kaibeckmann/weather-balloon-hat/images/PCB_board-top.png

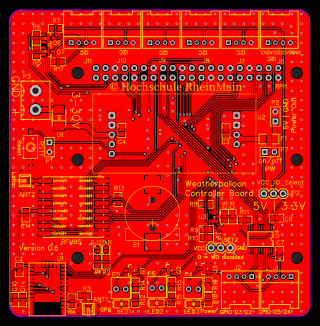
images/PCB_board-top.png
