kaibeckmann/weather-balloon-hat/images/schematic-sheet1.png

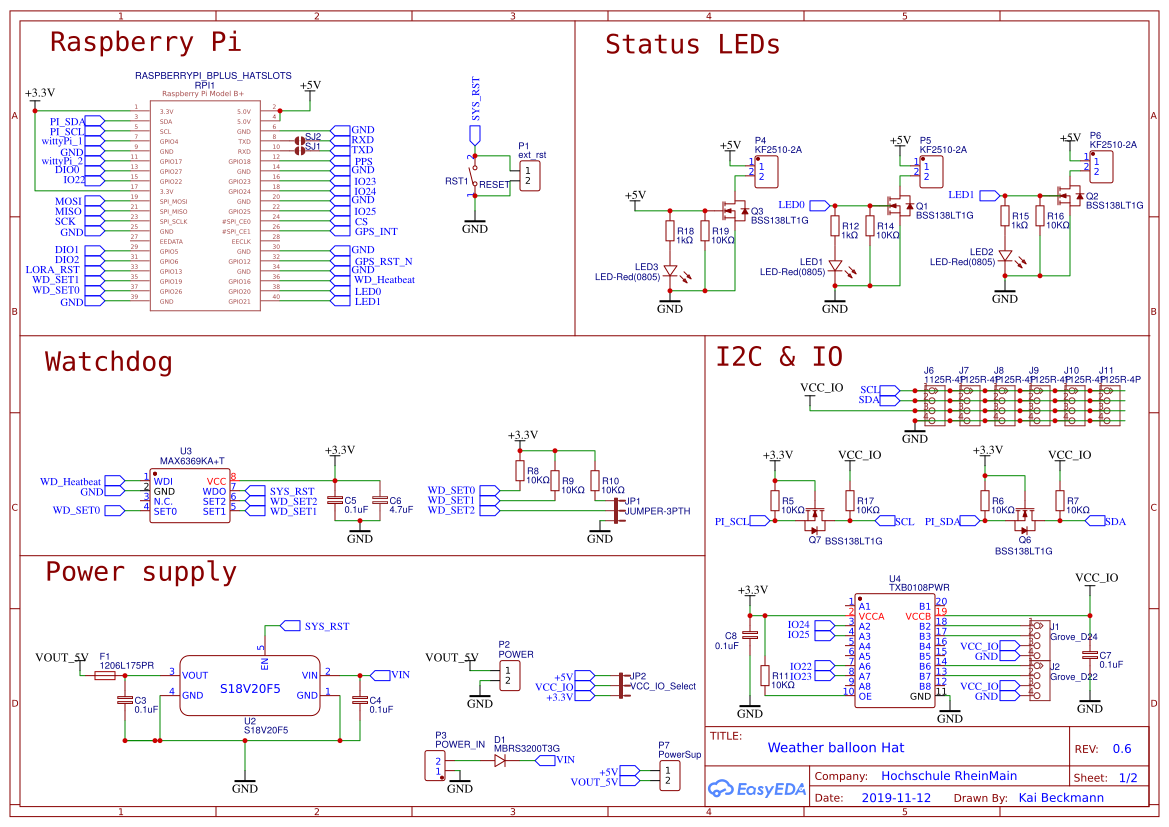
images/schematic-sheet1.png
