kaibeckmann/weather-balloon-hat/images/schematic-sheet2.png

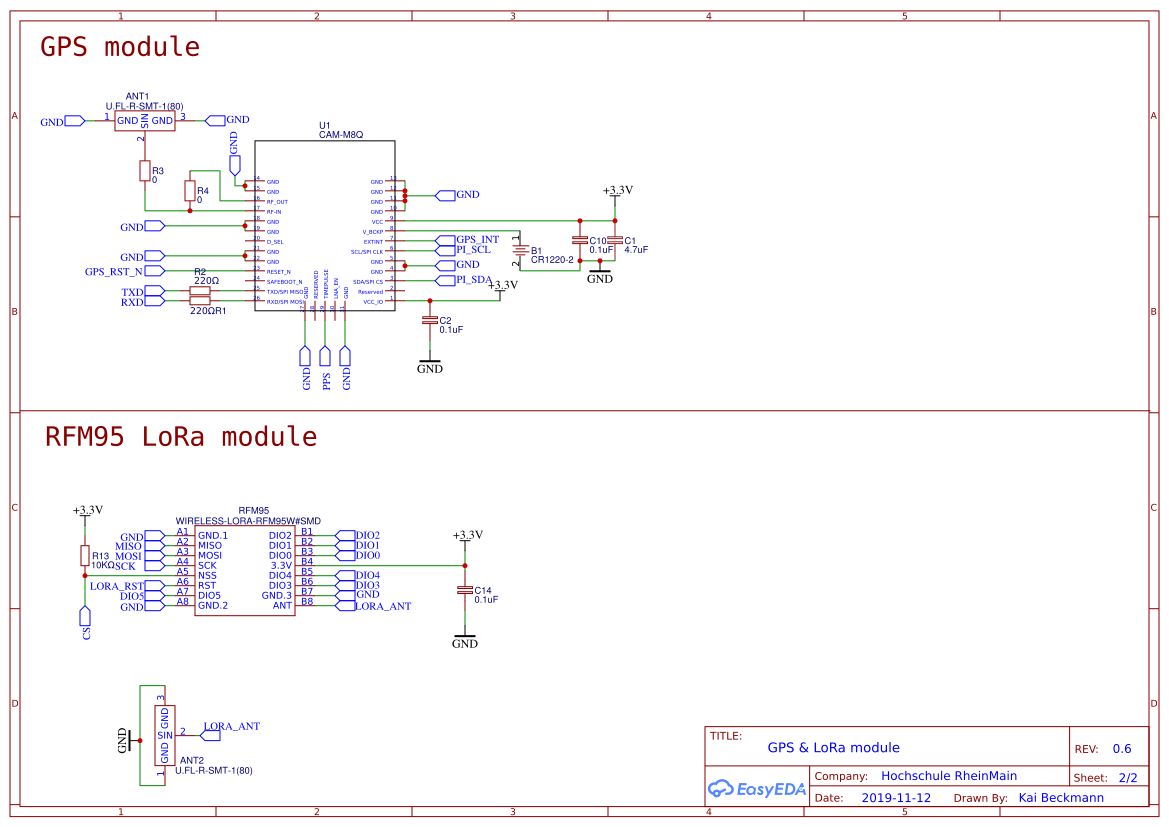
images/schematic-sheet2.png
