kaibeckmann/weather-balloon-hat/BOM/BOM_Weatherballoon-Hat_v0.6.csv

ID | Name | Designator | Footprint | Quantity | Manufacturer Part | Manufacturer | Supplier | Supplier Part | Value | LCSC Assembly | Tolerance | Voltage
1 | 10KΩ | R8,R9,R10,R11,R14,R16,R19,R7,R6,R5,R17 | 0805' | 11 | 0805W8F1002T5E | Uniroyal Elec | LCSC | C17414 | 10KΩ
2 | 1kΩ | R12,R15,R18 | 0805' | 3 | 0805W8F1001T5E | Uniroyal Elec | LCSC | C17513
3 | U.FL-R-SMT-1(80) | ANT1,ANT2 | U.FL-R-SMT-1(80) | 2 | U.FL-R-SMT-1(80) | HRS | LCSC | C88374
4 | 220Ω | R2,R1 | 0805' | 2
5 | 10KΩ | R13 | 0805' | 1 | 0805W8F1002T5E | UniOhm | LCSC | C17414 | 10KΩ
6 | WIRELESS-LORA-RFM95W#SMD | RFM95 | WIRELESS-LORA-RFM95WSMD | 1 | RFM95W-868S2 |  | RS-Online | 125-1259
7 | ext_rst | P1 | HDR-1X2/2.54 | 1 | 2.54-1*2PFemale | BOOMELE | LCSC | C49661
8 | POWER | P2 | HDR-1X2/2.54 | 1 | 2.54-1*2PFemale | BOOMELE | LCSC | C49661
9 | PowerSup | P7 | HDR-1X2/2.54 | 1 | 2.54-1*2PFemale | BOOMELE | LCSC | C49661
10 | TXB0108PWR | U4 | TSSOP-20 | 1 | TXB0108PWR | TI | LCSC | C53406 |  | Yes
11 | SOLDERJUMPERNO | SJ1,SJ2 | SJ_2S-NO | 2
12 | 0.1uF | C3,C4,C5,C7,C8,C2,C10,C14 | 0805' | 8 | CL21B105KAFNNNE | Samsung | LCSC | C116352 | 0.1uF |  | ±10% | 25V
13 | 4.7uF | C6,C1 | 0805' | 2
14 | Grove_D24 | J1 | HW4-2.0-90D | 1 | 1125R-4P
15 | Grove_D22 | J2 | HW4-2.0-90D | 1 | 1125R-4P
16 | 1125R-4P | J6,J7,J8,J9,J10,J11 | HW4-2.0-90D | 6 | 1125R-4P
17 | RASPBERRYPI_BPLUS_HATSLOTS | RPI1 | PI_HAT_SLOTS_COMBI | 1
18 | MAX6369KA+T | U3 | SOT-23-8 | 1 | MAX6369KA+T | MAXIM | LCSC | C128613 |  | Yes
19 | KF2510-2A | P4,P5,P6 | KF2510-2A | 3 | KF2510-2A | BOOMELE | LCSC | C27543
20 | 0 | R4,R3 | 0805' | 2
21 | CR1220-2 | B1 | BATTERY-2 | 1 | CR1220-2 | Q&J | LCSC | C70381
22 | JUMPER-3PTH | JP1 | 1X03 | 1
23 | VCC_IO_Select | JP2 | 1X03 | 1
24 | 1206L175PR | F1 | 1206 | 1 | 1206L175PR | Littelfuse | LCSC | C207038
25 | LED-Red(0805) | LED1,LED2,LED3 | LED-0805 | 3 | 17-21SURC/S530-A2/TR8 | Everlight Elec | LCSC | C131244
26 | CAM-M8Q | U1 | CAM-M8Q | 1 | CAM-M8Q | U-BLOX | Digi-Key | 672-1013-1-ND
27 | POWER_IN | P3 | WJ2EDGVC-5.08-2P | 1 | WJ2EDGVC-5.08-2P | ReliaPro | LCSC | C8445
28 | RESET | RST1 | K2-1107ST-A4SW-06 | 1 | K2-1107ST-A4SW-06 | Rectangular Connectors - Contacts | LCSC | C118141
29 | BSS138LT1G | Q1,Q2,Q3,Q6,Q7 | SOT-23(SOT-23-3) | 5 | BSS138LT1G | ON | LCSC | C82045 |  | Yes
30 | S18V20F5 | U2 | S18V20F5 | 1
31 | MBRS3200T3G | D1 | SMB(DO-214AA) | 1 | MBRS3200T3G | ON | LCSC | C86674 |  | Yes
