kaibeckmann/weather-balloon-hat/BOM/PCB_board-assembly.pdf

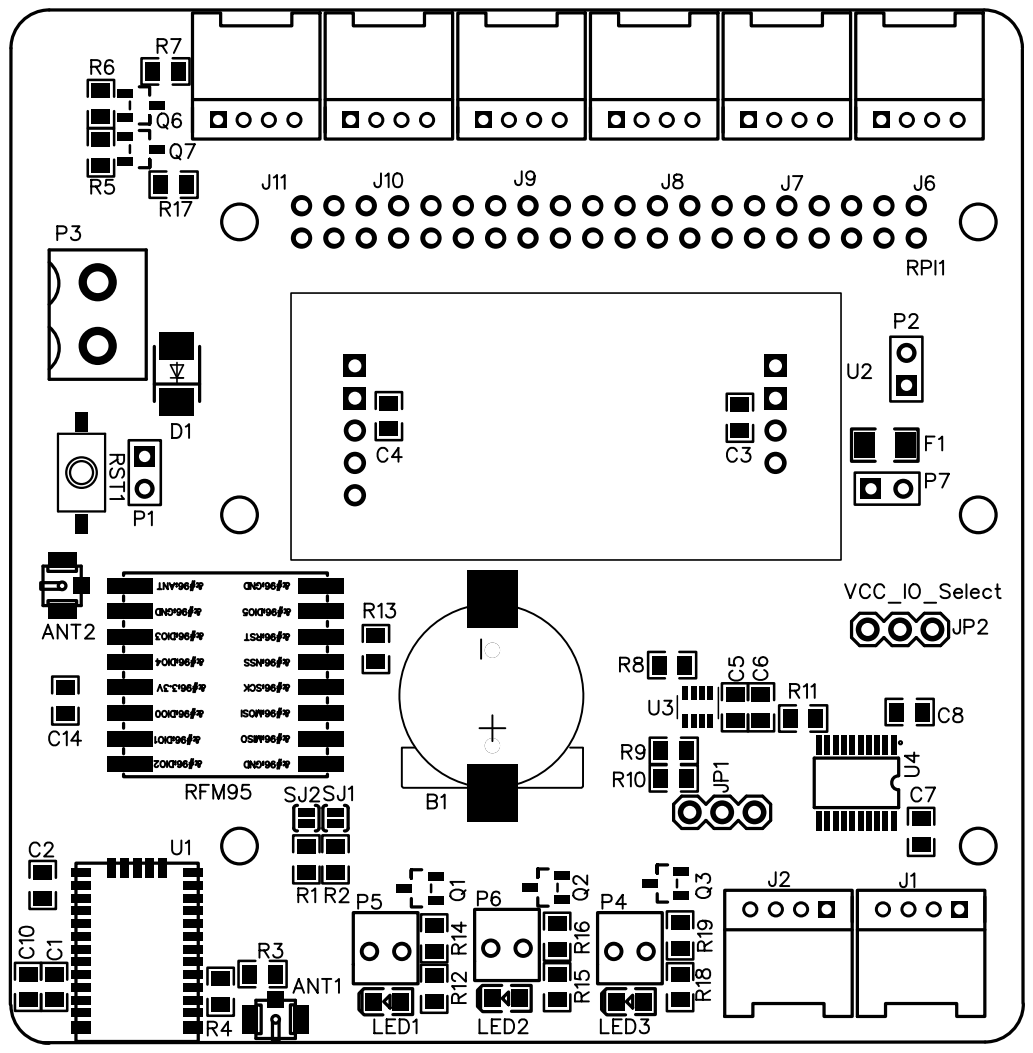
[picture p6: page 1]
