kaibeckmann/weather-balloon-hat/schematic/Schematic_Weatherballoon-Hat_v0.6.pdf

+5V
+3.3V

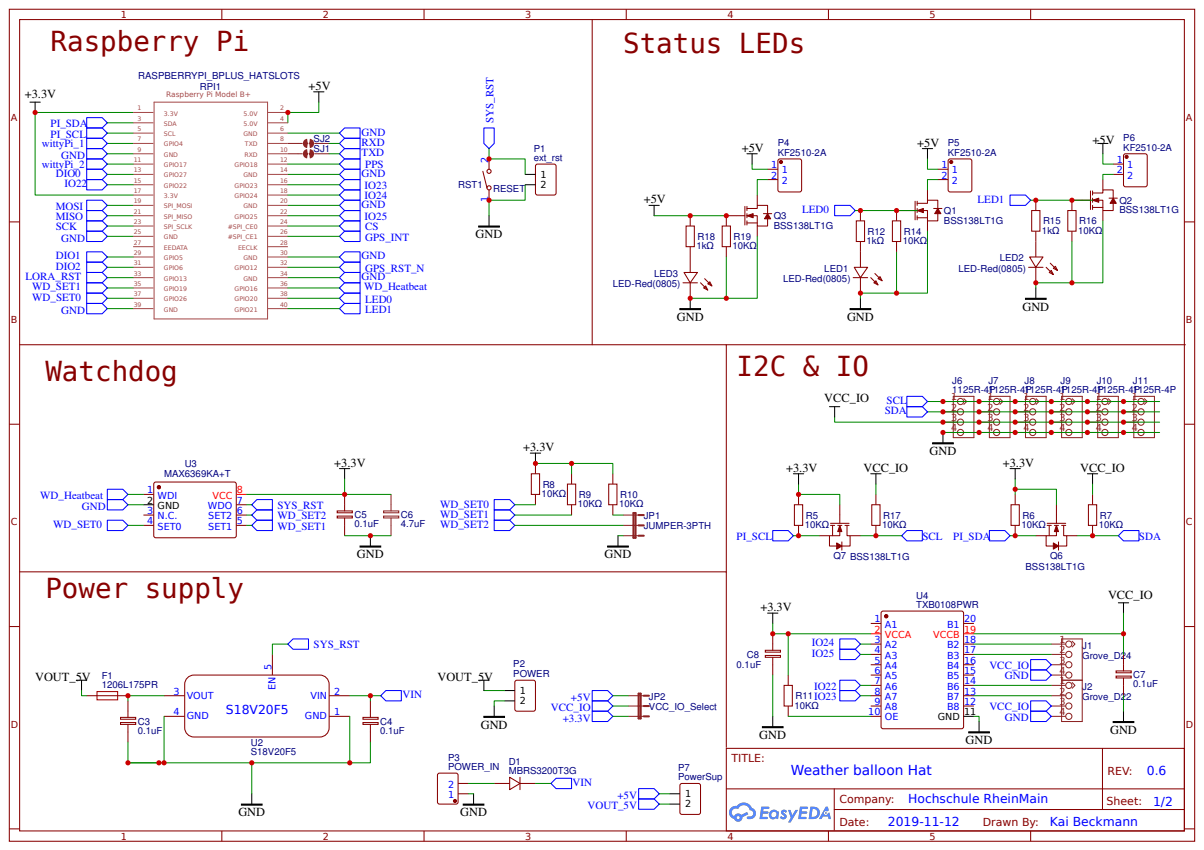
[picture p4: page 1]

Drawn By: Kai Beckmann

+3.3V

# GPS module

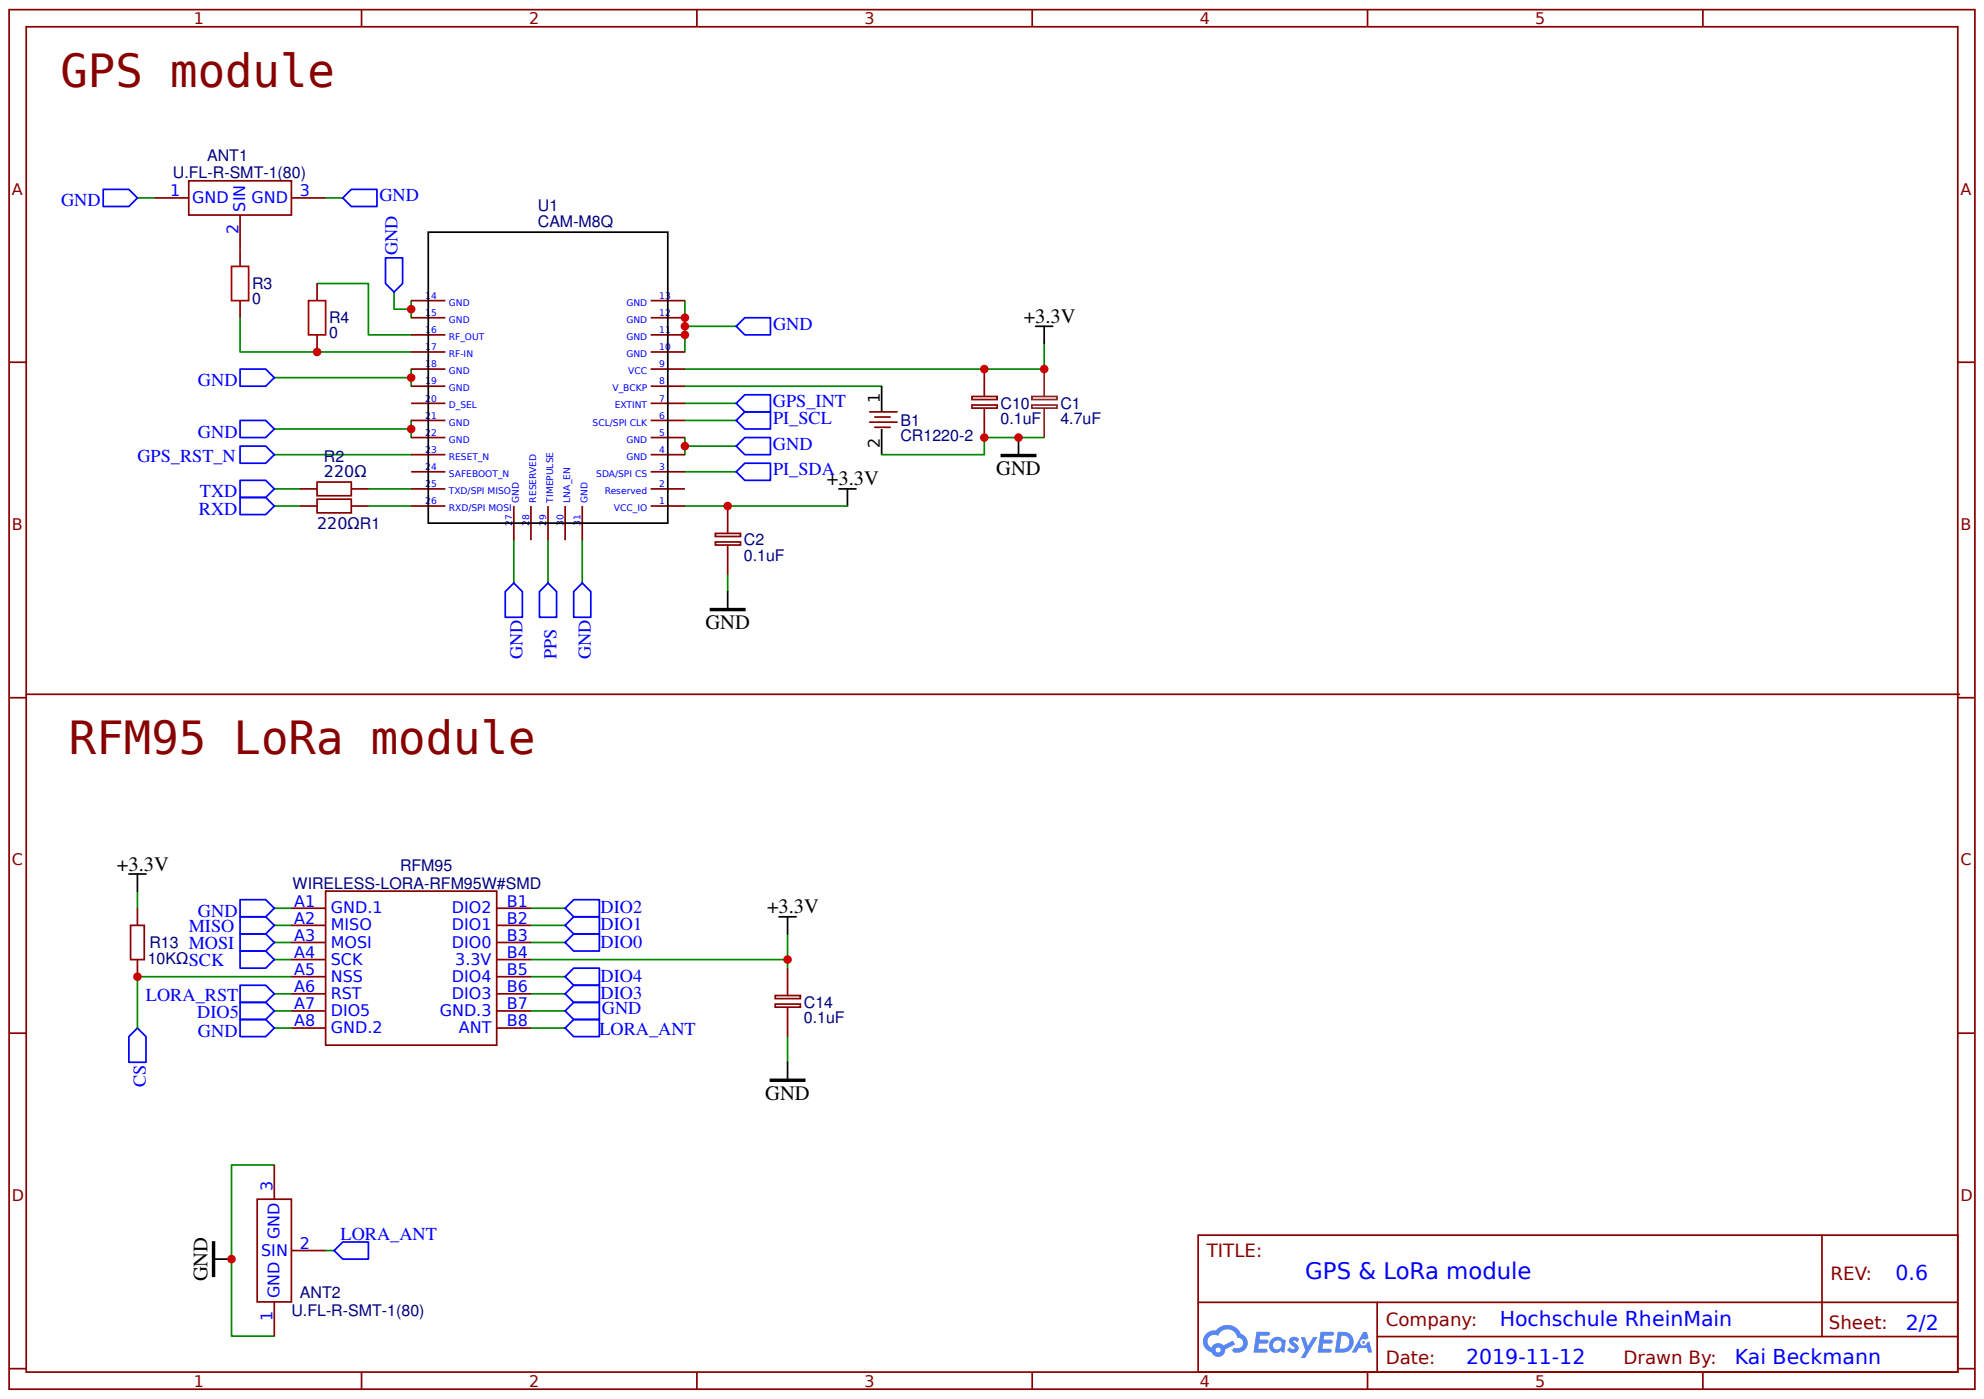
[picture p5: page 2]

Drawn By: Kai Beckmann
